AmorphousX/UMTK/README.md

# UMTK
Code for running UMTK

## Indicator LED

- Slow Flash: Not Connected
- Fast Flash: Running
- ON: Jogging
- OFF: Standby
