AmorphousX/UMTK/UMTK_ARDUINO/src/README.txt

This folder is the root of platformIO project
If need to be used with Arduino IDE, it must be symlinked somewhere, and be named UMTK
