AmorphousX/UMTK/PCB/V1/UMTK PCB/drawing.png

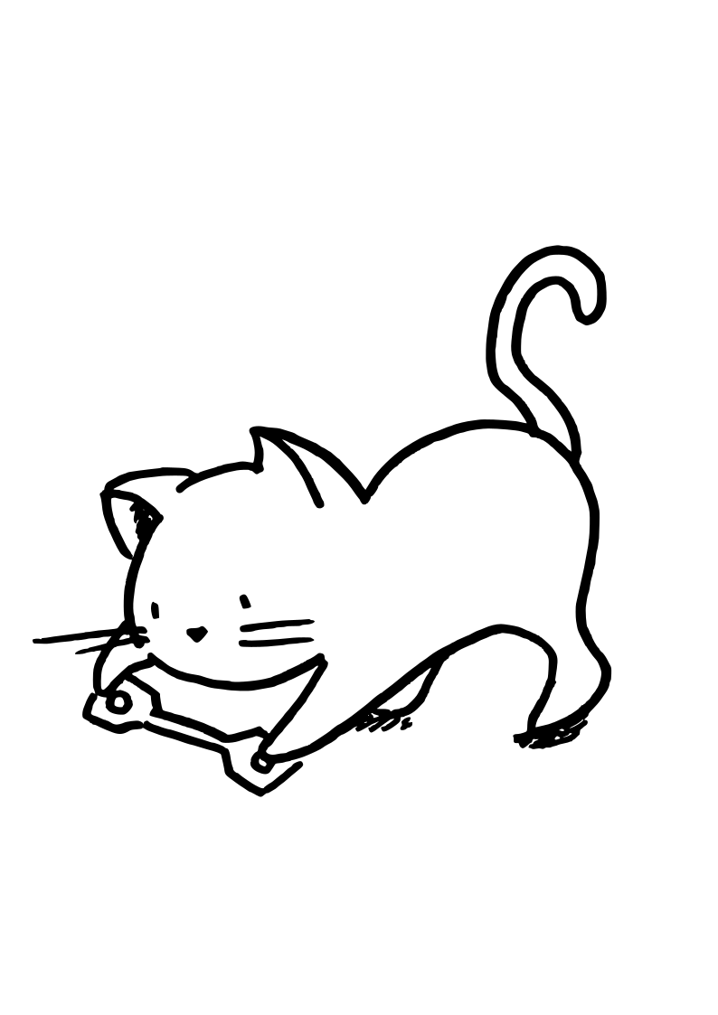
PCB/V1/UMTK PCB/drawing.png
