AmorphousX/UMTK/PCB/V1/UMTK PCB/PDF Image/UMTK_grey_Page_2.png

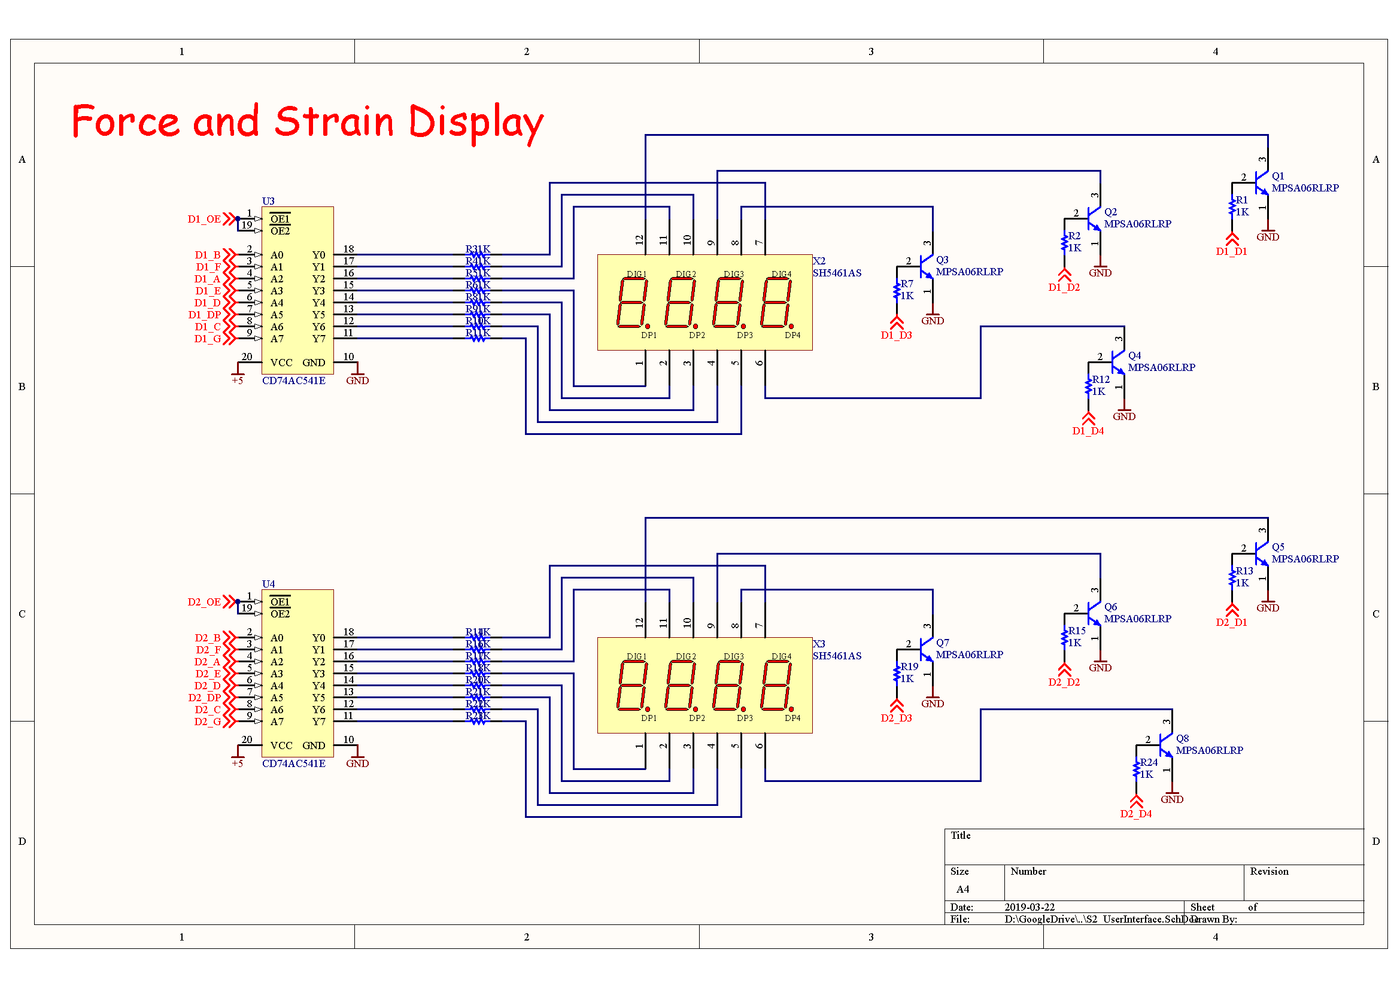
PCB/V1/UMTK PCB/PDF Image/UMTK_grey_Page_2.png
