AmorphousX/UMTK/PCB/V1/UMTK PCB/PDF Image/UMTK_grey_Page_5.png

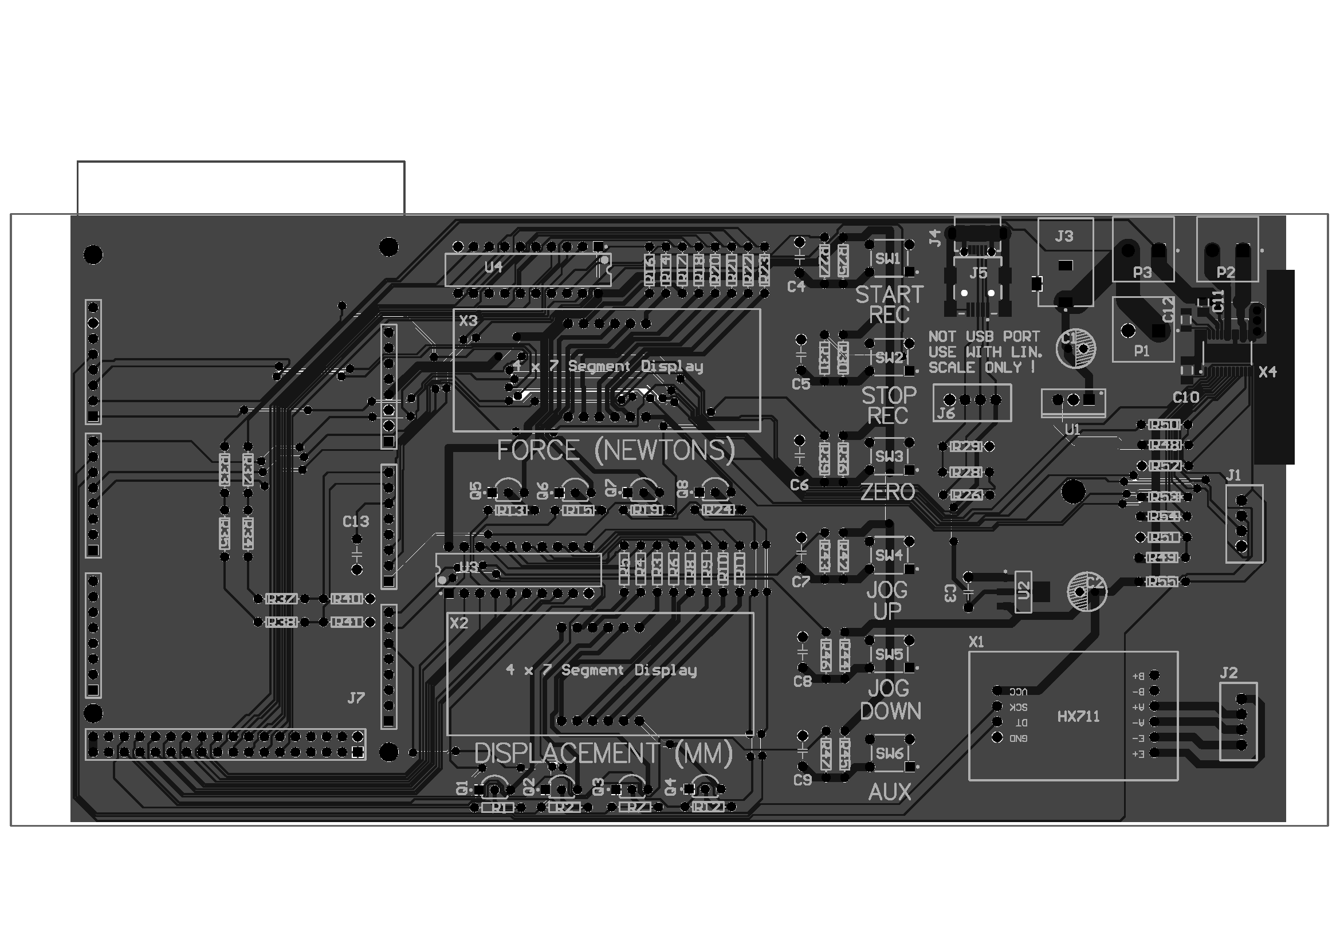
PCB/V1/UMTK PCB/PDF Image/UMTK_grey_Page_5.png
