AmorphousX/UMTK/UMTK_UI/v1.5/img/cat_1k.png

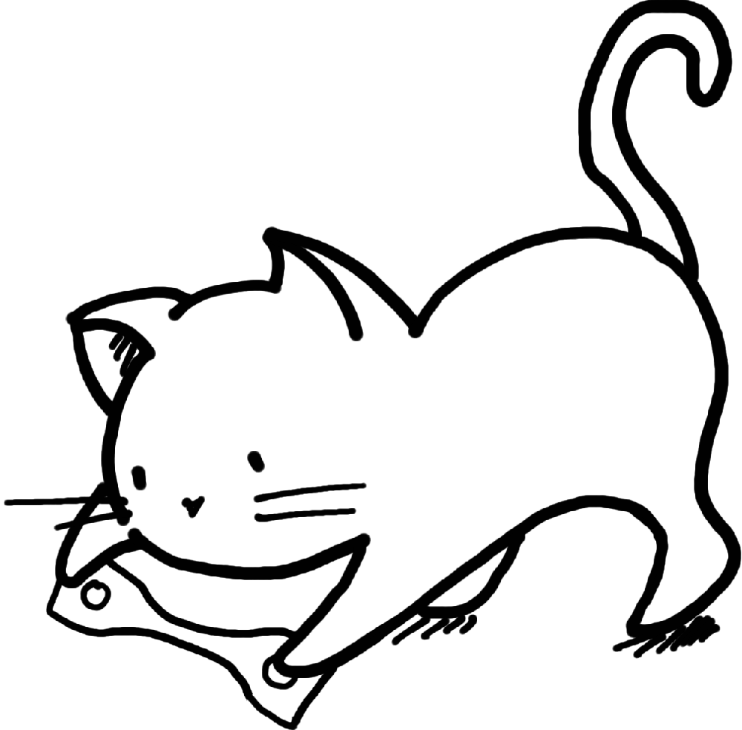
UMTK_UI/v1.5/img/cat_1k.png
