AmorphousX/UMTK/UMTK_UI/v1.5/img/cat_1k_dark.png

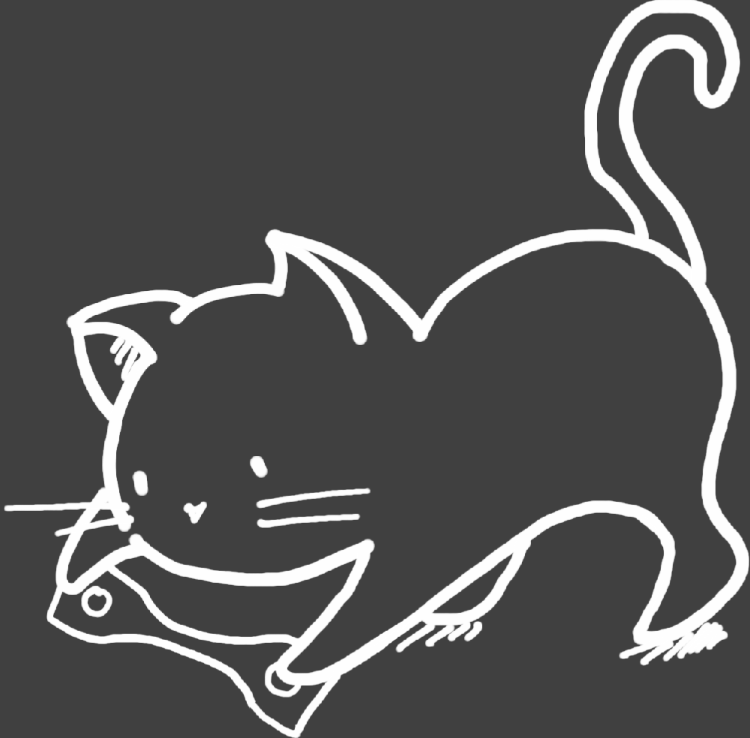
UMTK_UI/v1.5/img/cat_1k_dark.png
