AmorphousX/UMTK/PCB/V1/UMTK PCB/Project Outputs for UMTK/UMTK.xls

Comment | Description | Designator | Footprint | LibRef | Quantity | Need | Have
220u |  | C1, C2 | Alu Cap 6.3x2.5mm | Polar Cap | 2 | 8
0.1u |  | C3, C4, C5, C6, C7, C8, C9, C13 | Ceramic Cap 5mm | Cap | 8 | 32 | 32
CAP 1uF 6.3V 1206(3216) | CAP 1uF 6.3V ±20% 1206 (3216 Metric) Thickness 1.2mm SMD | C10 | CAPC1206(3216)130_M | CMP-1037-04669-1 | 1 | 4
CAP 1uF 25V 1206(3216) | CAP 1uF 25V ±10% 1206 (3216 Metric) Thickness 1.3mm SMD | C11 | CAPC1206(3216)130_M | CMP-1037-04700-1 | 1 | 4
CAP 47nF 50V 1206(3216) | CAP 47nF 50V ±20% 1206 (3216 Metric) Thickness 1.2mm SMD | C12 | CAPC1206(3216)130_L | CMP-1037-03986-1 | 1 | 4
JST 4pin |  | J1, J2, J6 | 4Pin JST | 4Pin JST | 3 | 12 | yes
PJ-102BH | Through Hole Right Angle DC Power Jack, 5 A, 2.5 mm Center Pin, 3 Position, -25 to 85 degC, RoHS, Bulk | J3 | CUI-PJ-102BH_V | CMP-2000-06901-1 | 1 | 4
47589-0001 | Right Angle Female Type AB Micro USB Connector, 30 V, 1.8 A, -30 to 85 degC, RoHS, Tape and Reel | J4 | MOLX-47589-0001_V | CMP-2000-05610-1 | 1 | 4
10033526-N3212LF | Mini USB B-Type, 5-Pin SMD, RoHS, Tape and Reel | J5 | FCI-10033526-N3212LF_V | CMP-1698-00001-2 | 1 | 4
NakedMega |  | J7 | ARDUINO MEGA | NakedMega | 1 | 4
SCREW-5.0/5.08 2WAYS | Socket, Screw Terminal Block, 2 Way, 5.0 mm Pitch, 90 Degree Angle, Through-Hole | P1, P2, P3 | SCREW-5.0-2WAYS_V | CMP-0617-00009-1 | 3 | 12
MPSA06RLRP | 80 V, 0.5 A, Amplifier Transistor, NPN Transistor, 3-Pin TO-92, Ammo Box | Q1, Q2, Q3, Q4, Q5, Q6, Q7, Q8 | ONSC-TO-92-3-29-11_AM_BL | CMP-1048-01505-1 | 8 | 32 | yes
Res1 | Resistor | R1, R2, R3, R4, R5, R6, R7, R8, R9, R10, R11, R12, R13, R14, R15, R16, R17, R18, R19, R20, R21, R22, R23, R24, R25, R26, R27, R28, R29, R30, R31, R32, R33, R34, R35, R36, R37, R38, R39, R40, R41, R42, R43, R44, R45, R46, R47, R48, R49, R50, R51, R52, R53, R54, R55 | AXIAL-0.3-3D | Res1 | 55 | 220 | yes
Tac Switch |  | SW1, SW2, SW3, SW4, SW5, SW6 | TacSwitch | Tac Switch | 6 | 24 | 24
L7805_Side |  | U1 | TO220_Side Mount | L7805_Side | 1 | 4 | yes
LD1117AS33TR | 1A, Low Drop Positive Voltage Regulator, 3.3V, 4-Pin SOT-223, Tape and Reel | U2 | SOT-223_M | CMP-0244-00316-1 | 1 | 4 | yes
CD74AC541E | Non-Inverting Octal Buffer/Line Drivers with 3-State Outputs, N0020A, TUBE | U3, U4 | N0020A | CMP-0440-00981-2 | 2 | 8
HX711_Board |  | X1 | HX711_Board_Large | HX711_Board | 1 | 4 | 4
SH5461AS | 4 Character 7 Segment Display, Common Cathode | X2, X3 | 4x7Seg | 4x7Seg | 2 | 8 | 8
DRV8873H | DRV8873-Q1 Automotive H-Bridge Motor Driver This one is the H version, with Hbridge gate controls (no SPI) | X4 | DRV8873 | DRV8873 | 1 | 4
