AmorphousX/UMTK/PCB/UMTK_V1_5/UMTK.step

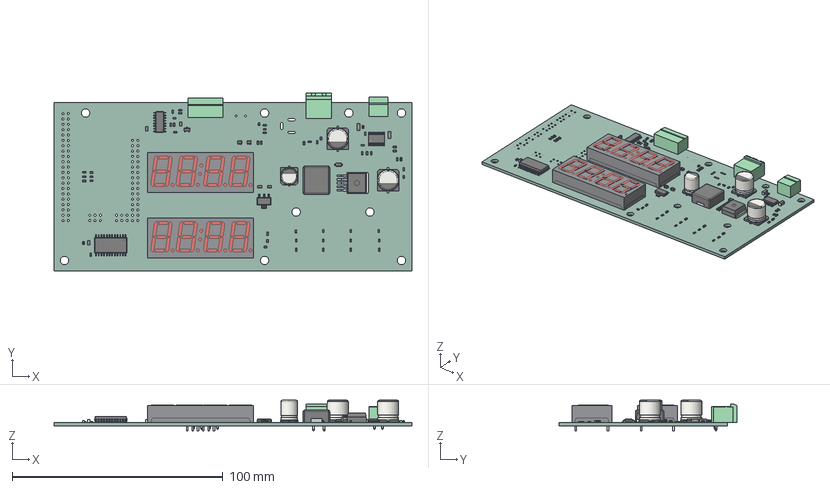
[picture p10: CAD file, 2024-09-10]
PCB/UMTK_V1_5/UMTK.step
170.0 x 84.5 x 14.5 mm
MC_01x02_G_3_81mm
C_0805_2012Metric x 5
C_0603_1608Metric x 14
R_0603_1608Metric x 36
D_SOD_523 x 2
SOIC_24W_75x154mm_P127mm
CQ assembly x 2
SOT_363_SC_70_6 x 2
C_1206_3216Metric x 2
CP_Elec_10x105 x 2
SOT_223
SOP-16_3.9x9.9mm_P1.27mm
Body_sp x 2
CP_Elec_8x105
D_SOD_123
HTSSOP_24_1EP_44x78mm_P065mm_EP34x78mm_Mask24x468mm
SOT_23
MC_01x04_G_3_81mm
MSTBA_01x02_G_5_08mm
UMTK_PCB
