AmorphousX/UMTK/PCB/v1.5_QA_Checklist.odt

PCB v1.5 QA Checklist

Date: 2024 Sep 15

- Power ON
- Display Segments
- Force +
- Force -
- Displacment +
- Displacement -
- LED Status light
- Motor Drive UP
- Motor Drive DOWN
- Tare
- Start Run
- Serial Print
- AUX Button Functions
- Remove Manufaturing Rail
- Temrinal – Loadcell
- Terminal – ESTOP
- Terminal – Motor

SN:

Tester:

PCB v1.5 QA Checklist

Date: 2024 Sep 15

- Power ON
- Display Segments
- Force +
- Force -
- Displacment +
- Displacement -
- LED Status light
- Motor Drive UP
- Motor Drive DOWN
- Tare
- Start Run
- Serial Print
- AUX Button Functions
- Remove Manufaturing Rail
- Temrinal – Loadcell
- Terminal – ESTOP
- Terminal – Motor

SN:

Tester:

PCB v1.5 QA Checklist

Date: 2024 Sep 15

- Power ON
- Display Segments
- Force +
- Force -
- Displacment +
- Displacement -
- LED Status light
- Motor Drive UP
- Motor Drive DOWN
- Tare
- Start Run
- Serial Print
- AUX Button Functions
- Remove Manufaturing Rail
- Temrinal – Loadcell
- Terminal – ESTOP
- Terminal – Motor

SN:

Tester:

PCB v1.5 QA Checklist

Date: 2024 Sep 15

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

SN:

Tester:
