AmorphousX/UMTK/(threads)

Thread 1 (2025-03-29):

UMTK PCB 1.6

MichaelDing313, 2025-03-29:
Need to fix issues discovered with PCB Version 1.5:

- EMI (maybe) from motor hitting endstop causes the slide to reset
  - Still need to investigate exactly why
  - Other functions don't seem affected
  - There is low capacitance on the power supply rails of slide, seems like easy mitigation

Thread 2 (2025-08-31):

McGill Meeting, Improvments

MichaelDing313, 2025-08-31:
Meeting with mcgill with feedbacks:

# GUI Issues:

- GUI Need to be started after USB plugin, rescan no work
- GUI Scaling
- GUI Install
  - Python version conflict on macos, With preinstalled python causes gui to fail
  -

# Hardware Issue:

- Calibration causes reading to be out of range
  - Calibration with bad values causes calibration values to be far out of range, and causes re-calibrations to fail
  -

Thread 3 (2025-08-31):

Mechanical Upgrade for slower strain rate

MichaelDing313, 2025-08-31:
We need much slower strain rate on the tests.

I think this is better done by getting a linear actuator with encoder, so we can optionally connect the encoder and drive the motors much slower than we otherwise able to.

- PCB needs to be updated with an optional encoder input. Absent encoder, we still need to rely on slide position.
- Software need to be updated to count the encoder. check if MEGA2560 can do it in hardware
- Find and buy motor with encoders.

MichaelDing313, 2025-08-31:
Ballpark say we target 20Khz - 100Khz max encoder frequency  at max speed.
Any higher we can also revert back to using linear slide as feedback and not encoder.

Spec for the linear actuator we used for v1.5 is:
- Load 6mm/s
- Unloaded 8mm/s
