AmorphousX/UMTK/(list of files, drawings)

Other design files:
PCB/V1/UMTK PCB/S1_Connections.SchDoc
PCB/V1/UMTK PCB/S2_UserInterface.SchDoc
PCB/V1/UMTK PCB/S3_Arduino.SchDoc
PCB/V1/UMTK PCB/S4_MotorDriver.SchDoc
PCB/V1/UMTK PCB/UMTK.PrjPCB
