AmorphousX/UMTK/PCB/UMTK_V1_5/UMTK.kicad_pcb

## KiCad design PCB/UMTK_V1_5/UMTK.kicad_pcb (2024-09-10)

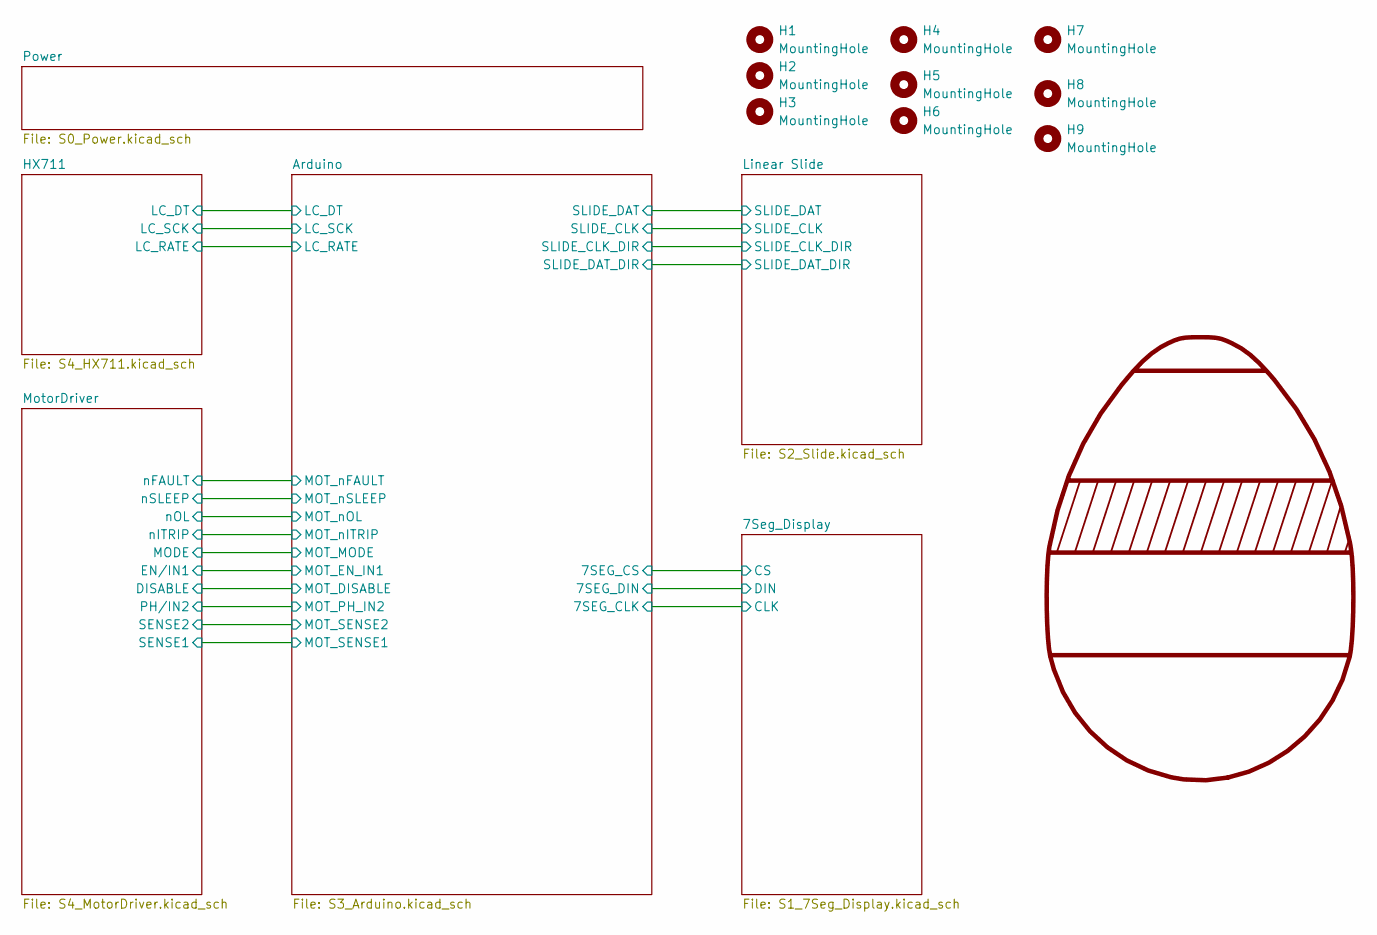
[picture p21: schematic UMTK.kicad_sch]

Parts:
G1: Tensile Cat
H1, H2, H3, H4, H5, H6, H7, H8, H9: MountingHole; MountingHole_4mm

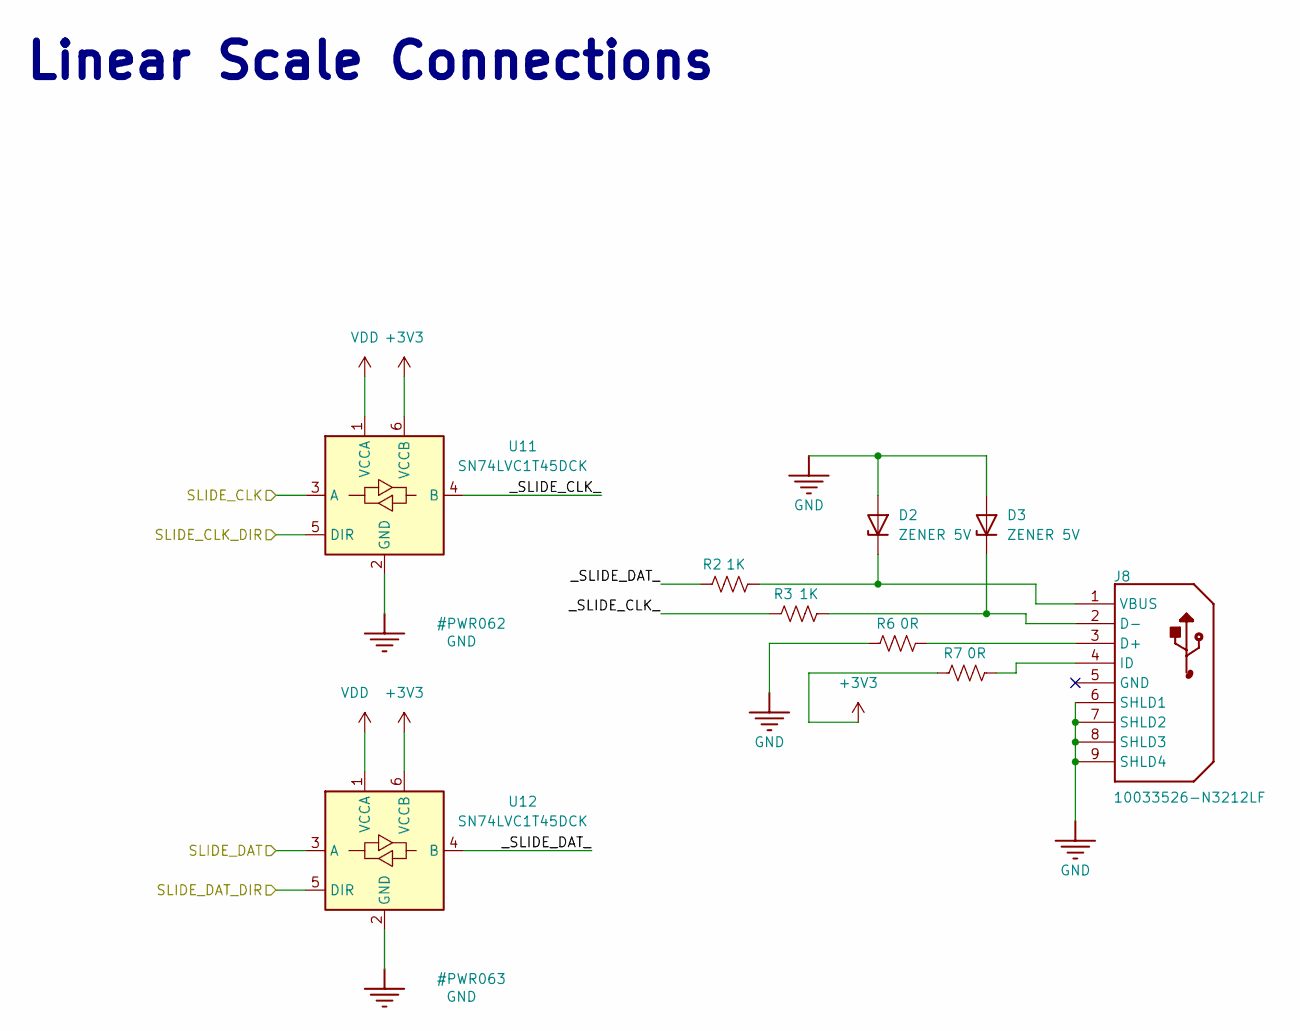
[picture p22: schematic S2_Slide.kicad_sch]

Parts:
D2, D3: ZENER 5V; D_SOD-523
J8: 10033526-N3212LF; USB_Mini-B_Wuerth_65100516121_Horizontal; FLAMMABILITY RATING UL 94 V-0; PARTNUMBER 10033526-N3212LF
R2, R3: 1K; R_0603_1608Metric
R6, R7: 0R; R_0603_1608Metric
U11, U12: SN74LVC1T45DCK; SOT-363_SC-70-6

Connections:
+3V3: R7.1, U11.6 (VCCB), U12.6 (VCCB); also elsewhere on the board
+5V: U11.1 (VCCA), U12.1 (VCCA); also elsewhere on the board
/Arduino/SLIDE_CLK: U11.3 (A); also elsewhere on the board
/Arduino/SLIDE_CLK_DIR: U11.5 (DIR); also elsewhere on the board
/Arduino/SLIDE_DAT: U12.3 (A); also elsewhere on the board
/Arduino/SLIDE_DAT_DIR: U12.5 (DIR); also elsewhere on the board
/Linear Slide/_SLIDE_CLK_: R3.1, U11.4 (B)
/Linear Slide/_SLIDE_DAT_: R2.1, U12.4 (B)
GND: D2.2 (A), D3.2 (A), J8.6 (SHLD1), J8.7 (SHLD2), J8.8 (SHLD3), J8.9 (SHLD4), R6.1, U11.2 (GND), U12.2 (GND); also elsewhere on the board
unnamed: D2.1 (K), J8.1 (VBUS), R2.2
unnamed: D3.1 (K), J8.2 (D-), R3.2
unnamed: J8.3 (D+), R6.2
unnamed: J8.4 (ID), R7.2

Notes on the sheet:
Linear Scale Connections

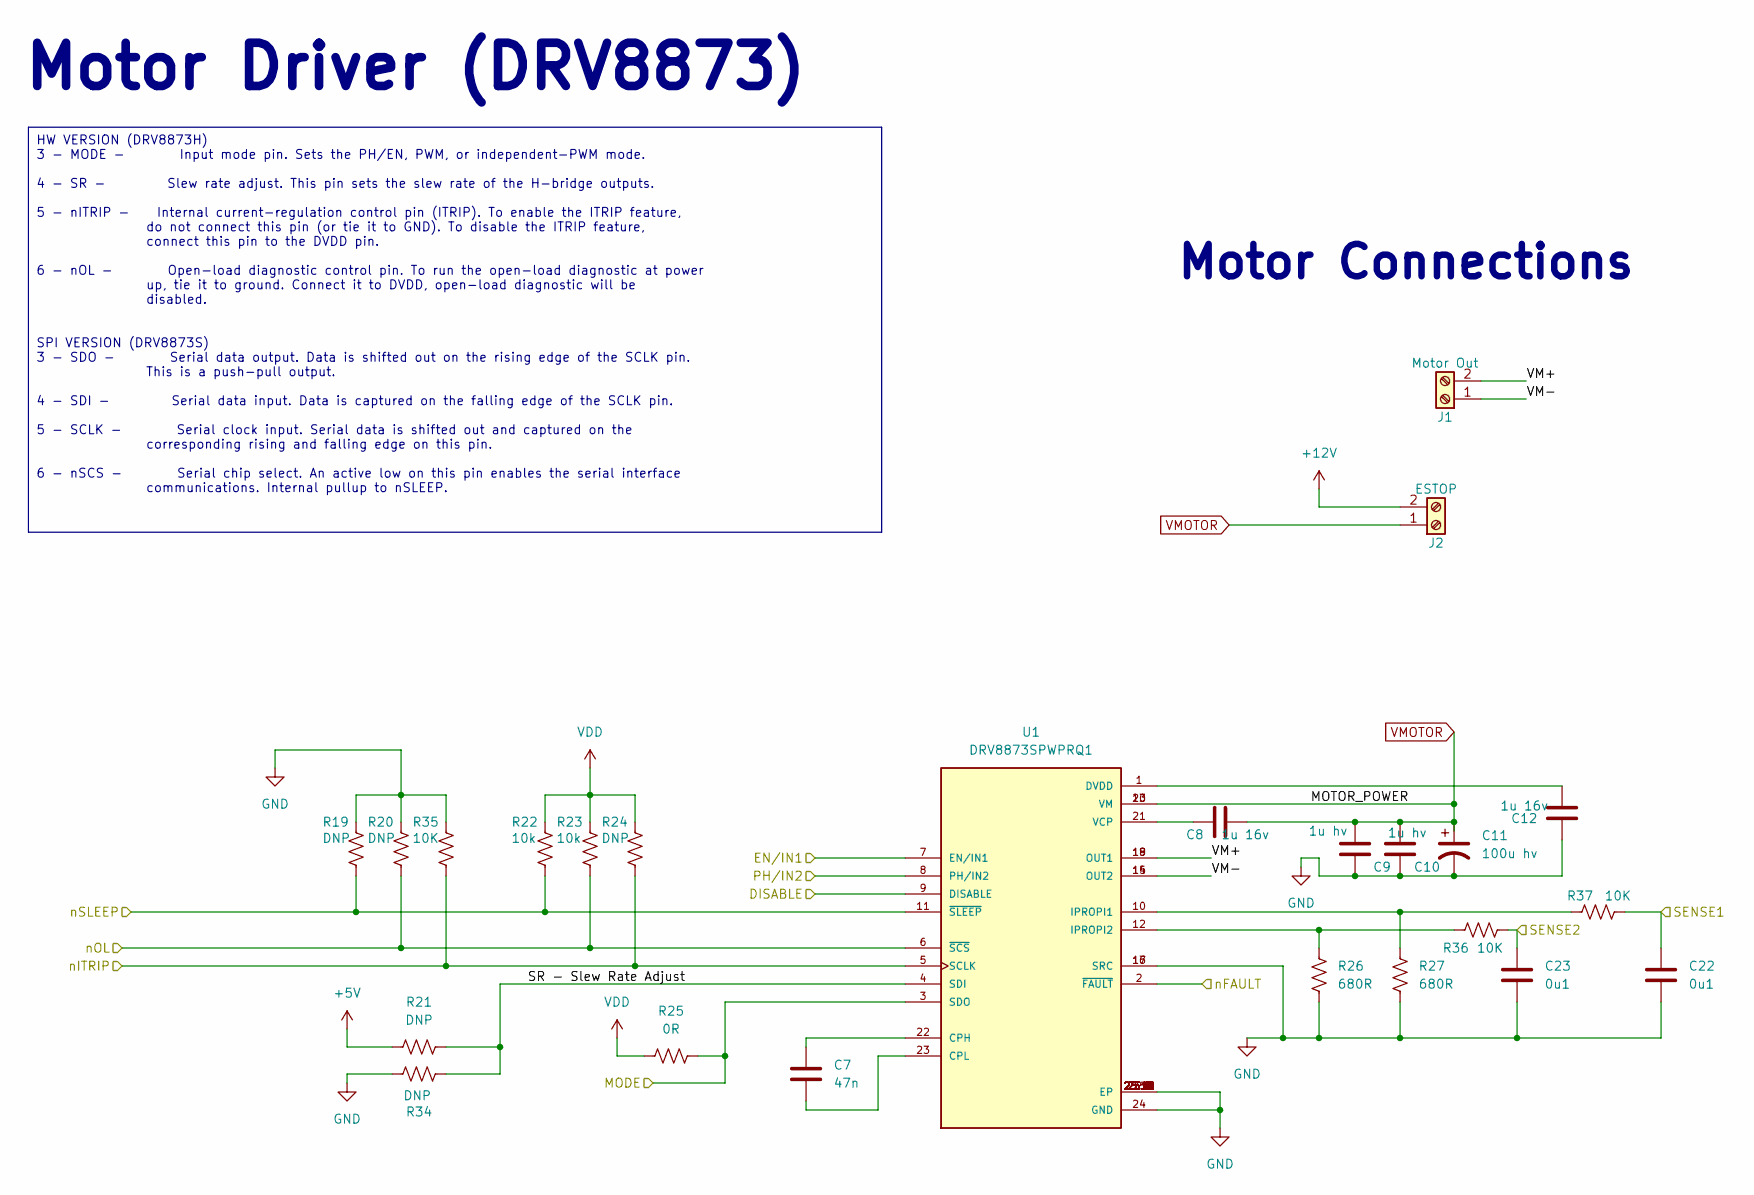
[picture p23: schematic S4_MotorDriver.kicad_sch]

Parts:
C7: 47n; C_0603_1608Metric
C8, C12: 1u 16v; C_0603_1608Metric
C9, C10: 1u hv; C_1206_3216Metric
C11: 100u hv; CP_Elec_10x10.5
C22, C23: 0u1; C_0603_1608Metric
J1: Motor Out; PhoenixContact_MC_1,5_2-G-3.81_1x02_P3.81mm_Horizontal
J2: ESTOP; PhoenixContact_MSTBA_2,5_2-G-5,08_1x02_P5.08mm_Horizontal
R19, R20, R21, R24, R34: DNP; R_0603_1608Metric
R22, R23: 10k; R_0603_1608Metric
R25: 0R; R_0603_1608Metric
R26, R27: 680R; R_0603_1608Metric
R35, R36, R37: 10K; R_0603_1608Metric
U1: DRV8873SPWPRQ1; HTSSOP-24-1EP_4.4x7.8mm_P0.65mm_EP3.4x7.8mm_Mask2.4x4.68mm_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; PARTREV A

Connections:
+5V: R21.2, R22.2, R23.2, R24.2, R25.1; also elsewhere on the board
+12V: J2.2; also elsewhere on the board
/Arduino/MOT_DISABLE: U1.9 (DISABLE); also elsewhere on the board
/Arduino/MOT_EN_IN1: U1.7 (EN/IN1); also elsewhere on the board
/Arduino/MOT_MODE: R25.2, U1.3 (SDO); also elsewhere on the board
/Arduino/MOT_PH_IN2: U1.8 (PH/IN2); also elsewhere on the board
/Arduino/MOT_SENSE1: C22.1, R37.2; also elsewhere on the board
/Arduino/MOT_SENSE2: C23.1, R36.2; also elsewhere on the board
/Arduino/MOT_nFAULT: U1.2 (~FAULT); also elsewhere on the board
/Arduino/MOT_nITRIP: R24.1, R35.1, U1.5 (SCLK); also elsewhere on the board
/Arduino/MOT_nOL: R20.1, R23.1, U1.6 (~SCS); also elsewhere on the board
/Arduino/MOT_nSLEEP: R19.1, R22.1, U1.11 (~SLEEP); also elsewhere on the board
/MotorDriver/SR - Slew Rate Adjust: R21.1, R34.2, U1.4 (SDI)
/MotorDriver/VM+: J1.2, U1.18 (OUT1), U1.19 (OUT1)
/MotorDriver/VM-: J1.1, U1.14 (OUT2), U1.15 (OUT2)
GND: C9.1, C10.1, C11.2, C12.2, C22.2, C23.2, R19.2, R20.2, R26.1, R27.1, R34.1, R35.2, U1.16 (SRC), U1.17 (SRC), U1.24 (GND), U1.25 (EP), U1.25.1 (EP), U1.25.2 (EP), U1.25.3 (EP), U1.25.4 (EP), U1.25.5 (EP), U1.25.6 (EP), U1.25.7 (EP), U1.25.8 (EP), U1.25.9 (EP), U1.25.10 (EP), U1.25.11 (EP), U1.25.12 (EP), U1.25.13 (EP), U1.25.14 (EP), U1.25.15 (EP), U1.25.16 (EP), U1.25.17 (EP), U1.25.18 (EP); also elsewhere on the board
unnamed: C7.1, U1.22 (CPH)
unnamed: C7.2, U1.23 (CPL)
unnamed: C12.1, U1.1 (DVDD)
unnamed: R27.2, R37.1, U1.10 (IPROPI1)
unnamed: R26.2, R36.1, U1.12 (IPROPI2)
unnamed: C8.1, U1.21 (VCP)
VMOTOR: C8.2, C9.2, C10.2, C11.1, J2.1, U1.13 (VM), U1.20 (VM); also elsewhere on the board

Notes on the sheet:
HW VERSION (DRV8873H) 3 - MODE - Input mode pin. Sets the PH/EN, PWM, or independent-PWM mode. 4 - SR - Slew rate adjust. This pin sets the slew rate of the H-bridge outputs. 5 - nITRIP - Internal current-regulation control pin (ITRIP). To enable the ITRIP feature, do not connect this pin (or tie i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
Motor Connections
Motor Driver (DRV8873)

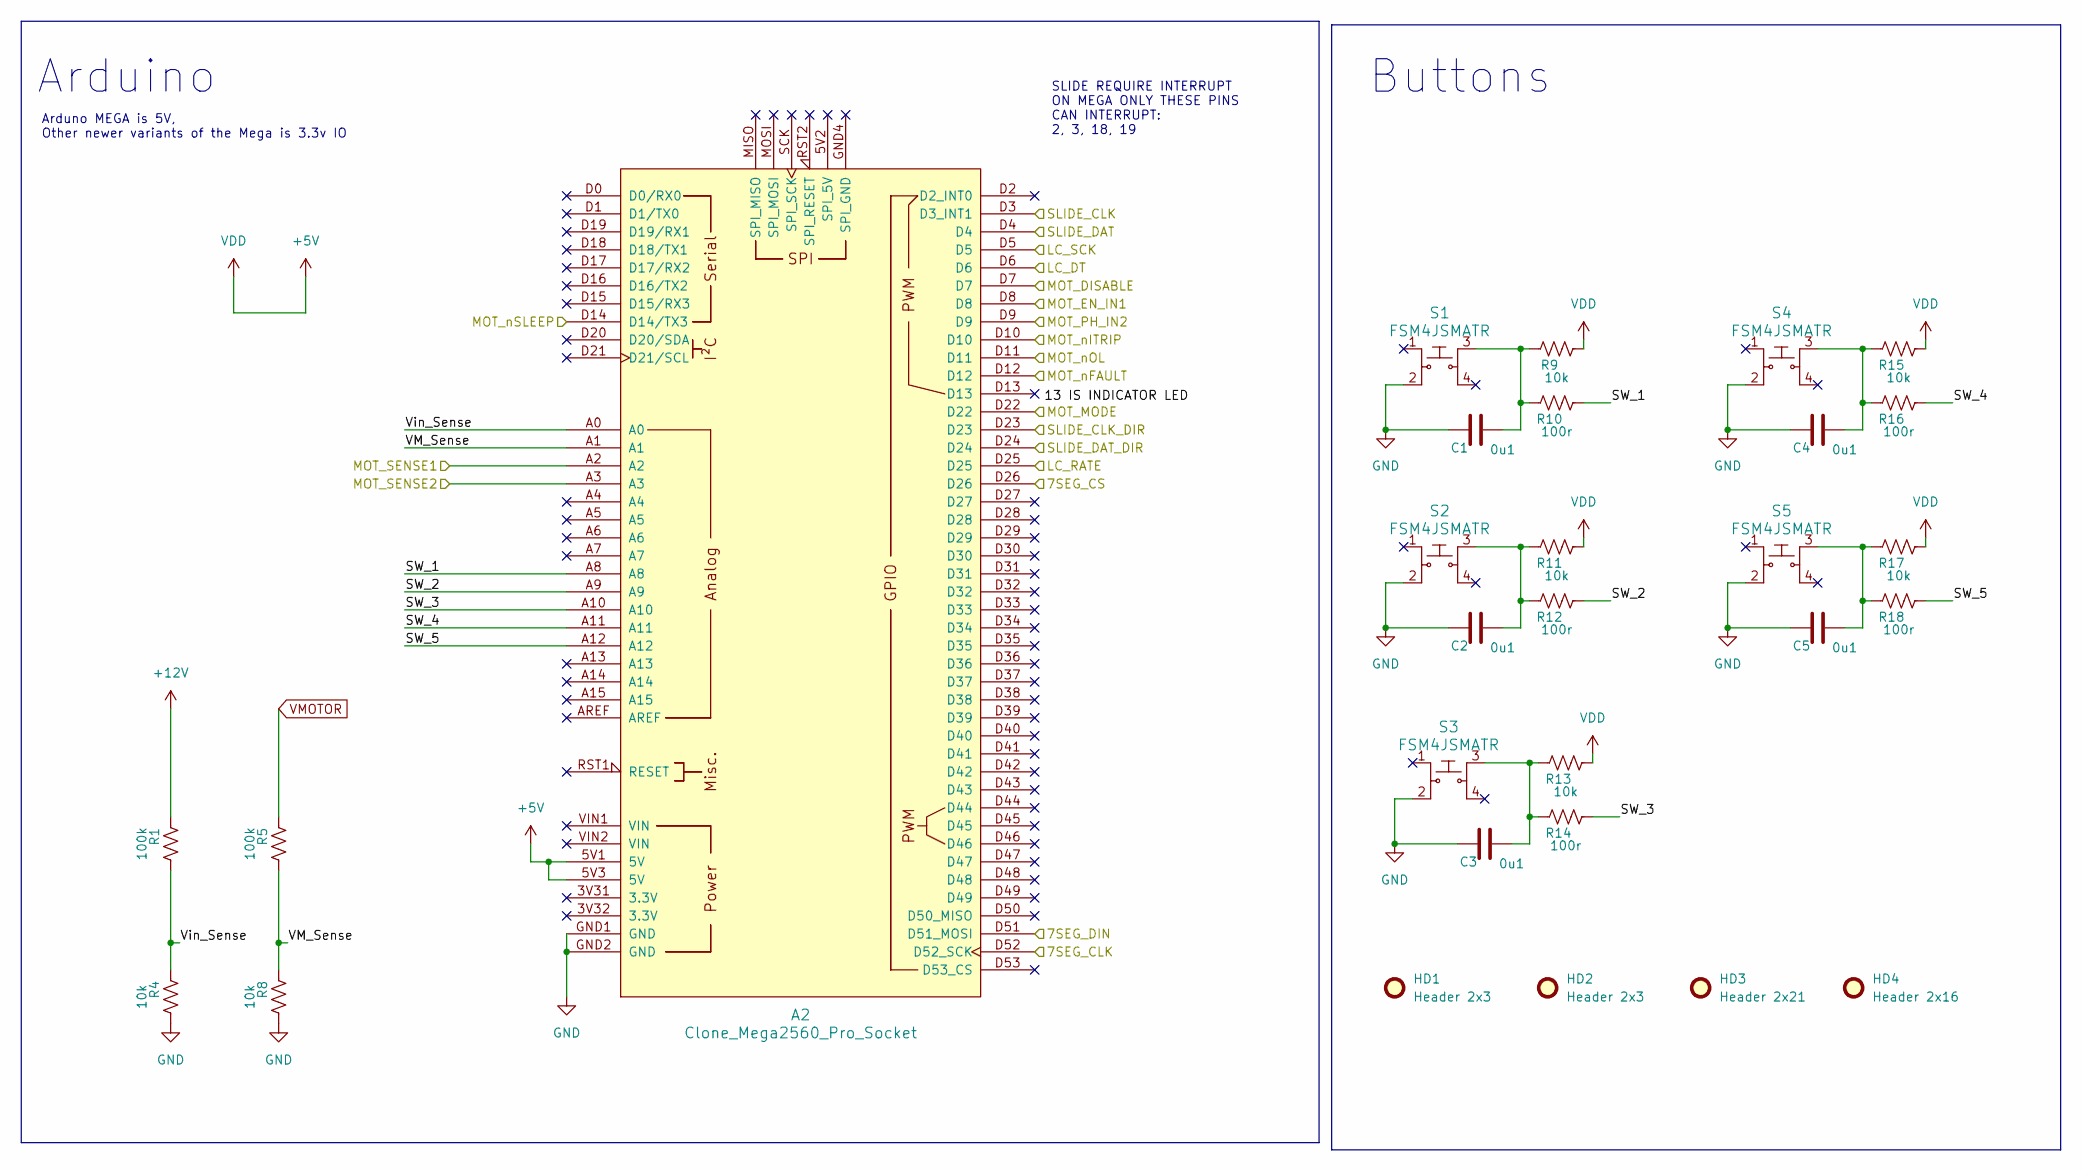
[picture p24: schematic S3_Arduino.kicad_sch]

Parts:
A2: Clone_Mega2560_Pro_Socket
C1, C2, C3, C4, C5: 0u1; C_0603_1608Metric
HD1, HD2: Header 2x3; Dummy_Header_2x3
HD3: Header 2x21; Dummy_Header_2x21
HD4: Header 2x16; Dummy_Header_2x16
R1, R5: 100k; R_0603_1608Metric
R4, R8, R9, R11, R13, R15, R17: 10k; R_0603_1608Metric
R10, R12, R14, R16, R18: 100r; R_0603_1608Metric
S1, S2, S3, S4, S5: FSM4JSMATR; Switch_Tactile_SMD_6x6mm; MPN FSM4JSMATR; Digi-Key_PN 450-1759-1-ND

Connections:
+5V: A2.5V1 (5V), A2.5V3 (5V), R9.2, R11.2, R13.2, R15.2, R17.2; also elsewhere on the board
+12V: R1.1; also elsewhere on the board
/7Seg_Display/CLK: A2.D52 (D52_SCK); also elsewhere on the board
/7Seg_Display/CS: A2.D26; also elsewhere on the board
/7Seg_Display/DIN: A2.D51 (D51_MOSI); also elsewhere on the board
/Arduino/LC_DT: A2.D6; also elsewhere on the board
/Arduino/LC_RATE: A2.D25; also elsewhere on the board
/Arduino/LC_SCK: A2.D5; also elsewhere on the board
/Arduino/MOT_DISABLE: A2.D7; also elsewhere on the board
/Arduino/MOT_EN_IN1: A2.D8; also elsewhere on the board
/Arduino/MOT_MODE: A2.D22; also elsewhere on the board
/Arduino/MOT_PH_IN2: A2.D9; also elsewhere on the board
/Arduino/MOT_SENSE1: A2.A2; also elsewhere on the board
/Arduino/MOT_SENSE2: A2.A3; also elsewhere on the board
/Arduino/MOT_nFAULT: A2.D12; also elsewhere on the board
/Arduino/MOT_nITRIP: A2.D10; also elsewhere on the board
/Arduino/MOT_nOL: A2.D11; also elsewhere on the board
/Arduino/MOT_nSLEEP: A2.D14 (D14/TX3); also elsewhere on the board
/Arduino/SLIDE_CLK: A2.D3 (D3_INT1); also elsewhere on the board
/Arduino/SLIDE_CLK_DIR: A2.D23; also elsewhere on the board
/Arduino/SLIDE_DAT: A2.D4; also elsewhere on the board
/Arduino/SLIDE_DAT_DIR: A2.D24; also elsewhere on the board
/Arduino/SW_1: A2.A8, R10.2
/Arduino/SW_2: A2.A9, R12.2
/Arduino/SW_3: A2.A10, R14.2
/Arduino/SW_4: A2.A11, R16.2
/Arduino/SW_5: A2.A12, R18.2
/Arduino/VM_Sense: A2.A1, R5.2, R8.1
/Arduino/Vin_Sense: A2.A0, R1.2, R4.1
GND: A2.GND1 (GND), A2.GND2 (GND), C1.1, C2.1, C3.1, C4.1, C5.1, R4.2, R8.2, S1.2, S2.2, S3.2, S4.2, S5.2; also elsewhere on the board
unnamed: C1.2, R9.1, R10.1, S1.3
unnamed: C2.2, R11.1, R12.1, S2.3
unnamed: C3.2, R13.1, R14.1, S3.3
unnamed: C4.2, R15.1, R16.1, S4.3
unnamed: C5.2, R17.1, R18.1, S5.3
VMOTOR: R5.1; also elsewhere on the board

Notes on the sheet:
Arduno MEGA is 5V, Other newer variants of the Mega is 3.3v IO
Arduino
SLIDE REQUIRE INTERRUPT ON MEGA ONLY THESE PINS CAN INTERRUPT: 2, 3, 18, 19
Buttons

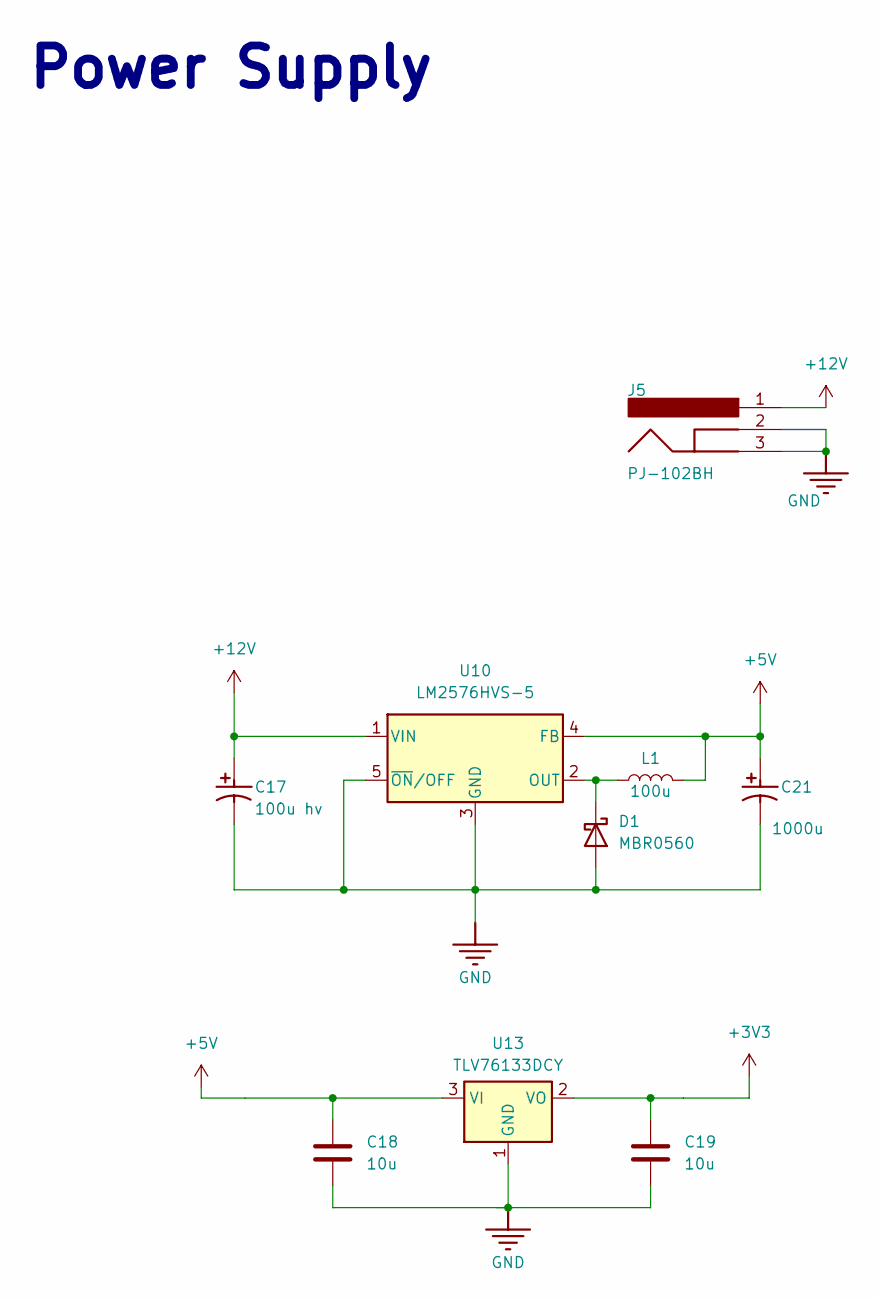
[picture p25: schematic S0_Power.kicad_sch]

Parts:
C17: 100u hv; CP_Elec_10x10.5
C18, C19: 10u; C_0805_2012Metric
C21: 1000u; CP_Elec_8x10.5
D1: MBR0560; D_SOD-123
J5: PJ-102BH; Barrel_Jack_5.5mmODx2.1mmID_PJ-202A; CURRENT RATING 5A; FLAMMABILITY RATING UL94V-0
L1: 100u; L_Sunlord_MWSA1206S-101
U10: LM2576HVS-5; TO-263-5_TabPin3
U13: TLV76133DCY; SOT-223-3_TabPin2

Connections:
+3V3: C19.2, U13.2 (VO); also elsewhere on the board
+5V: C18.2, C21.1, L1.2, U10.4 (FB), U13.3 (VI); also elsewhere on the board
+12V: C17.1, J5.1, U10.1 (VIN); also elsewhere on the board
GND: C17.2, C18.1, C19.1, C21.2, D1.2 (A), J5.2, J5.3, U10.3 (GND), U10.5 (~ON/OFF), U13.1 (GND); also elsewhere on the board
unnamed: D1.1 (K), L1.1, U10.2 (OUT)

Notes on the sheet:
Power Supply

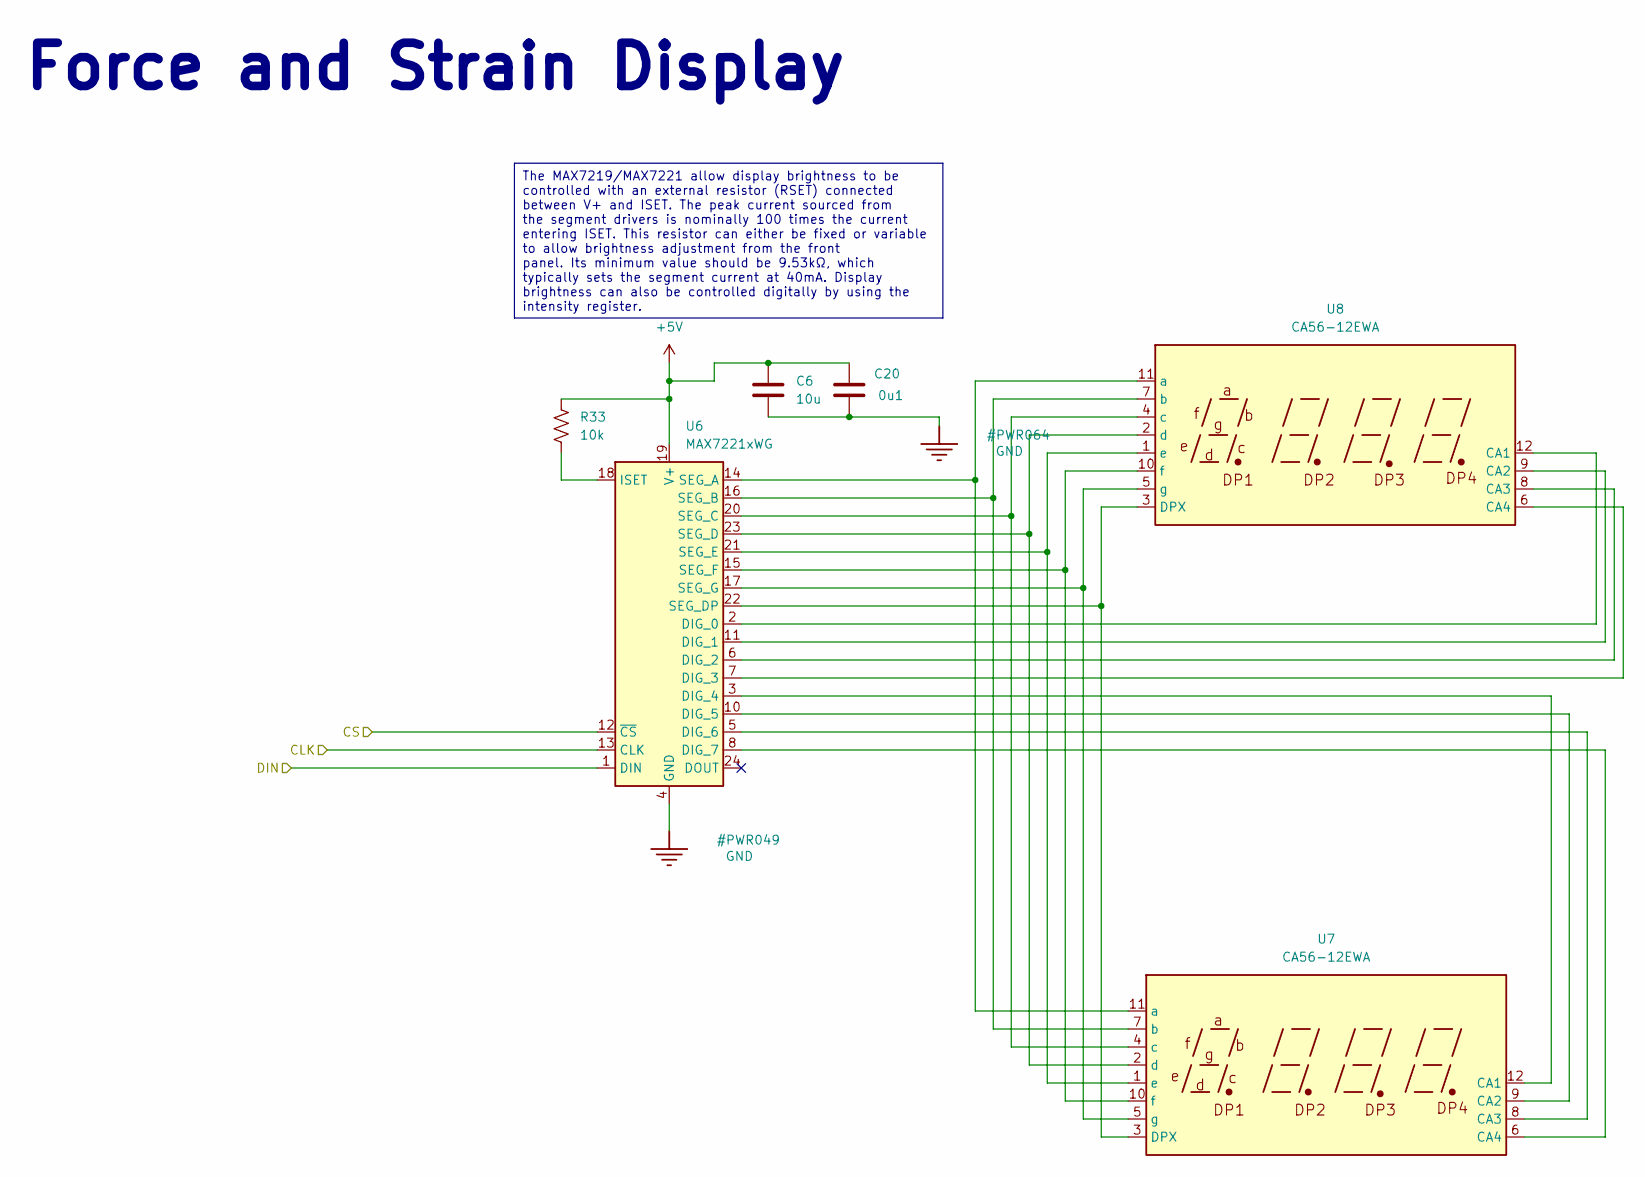
[picture p26: schematic S1_7Seg_Display.kicad_sch]

Parts:
C6: 10u; C_0805_2012Metric
C20: 0u1; C_0603_1608Metric
R33: 10k; R_0603_1608Metric
U6: MAX7221xWG; SOIC-24W_7.5x15.4mm_P1.27mm
U7, U8: CA56-12EWA

Connections:
+5V: C6.2, C20.2, R33.1, U6.19 (V+); also elsewhere on the board
/7Seg_Display/CLK: U6.13 (CLK); also elsewhere on the board
/7Seg_Display/CS: U6.12 (~CS); also elsewhere on the board
/7Seg_Display/DIN: U6.1 (DIN); also elsewhere on the board
GND: C6.1, C20.1, U6.4 (GND), U6.9 (GND); also elsewhere on the board
unnamed: U6.2 (DIG_0), U8.12 (CA1)
unnamed: U6.11 (DIG_1), U8.9 (CA2)
unnamed: U6.6 (DIG_2), U8.8 (CA3)
unnamed: U6.7 (DIG_3), U8.6 (CA4)
unnamed: U6.3 (DIG_4), U7.12 (CA1)
unnamed: U6.10 (DIG_5), U7.9 (CA2)
unnamed: U6.5 (DIG_6), U7.8 (CA3)
unnamed: U6.8 (DIG_7), U7.6 (CA4)
unnamed: R33.2, U6.18 (ISET)
unnamed: U6.14 (SEG_A), U7.11 (a), U8.11 (a)
unnamed: U6.16 (SEG_B), U7.7 (b), U8.7 (b)
unnamed: U6.20 (SEG_C), U7.4 (c), U8.4 (c)
unnamed: U6.23 (SEG_D), U7.2 (d), U8.2 (d)
unnamed: U6.22 (SEG_DP), U7.3 (DPX), U8.3 (DPX)
unnamed: U6.21 (SEG_E), U7.1 (e), U8.1 (e)
unnamed: U6.15 (SEG_F), U7.10 (f), U8.10 (f)
unnamed: U6.17 (SEG_G), U7.5 (g), U8.5 (g)

Notes on the sheet:
The MAX7219/MAX7221 allow display brightness to be controlled with an external resistor (RSET) connected between V+ and ISET. The peak current sourced from the segment drivers is nominally 100 times the current entering ISET. This resistor can either be fixed or variable to allow brightness adjustm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
Force and Strain Display

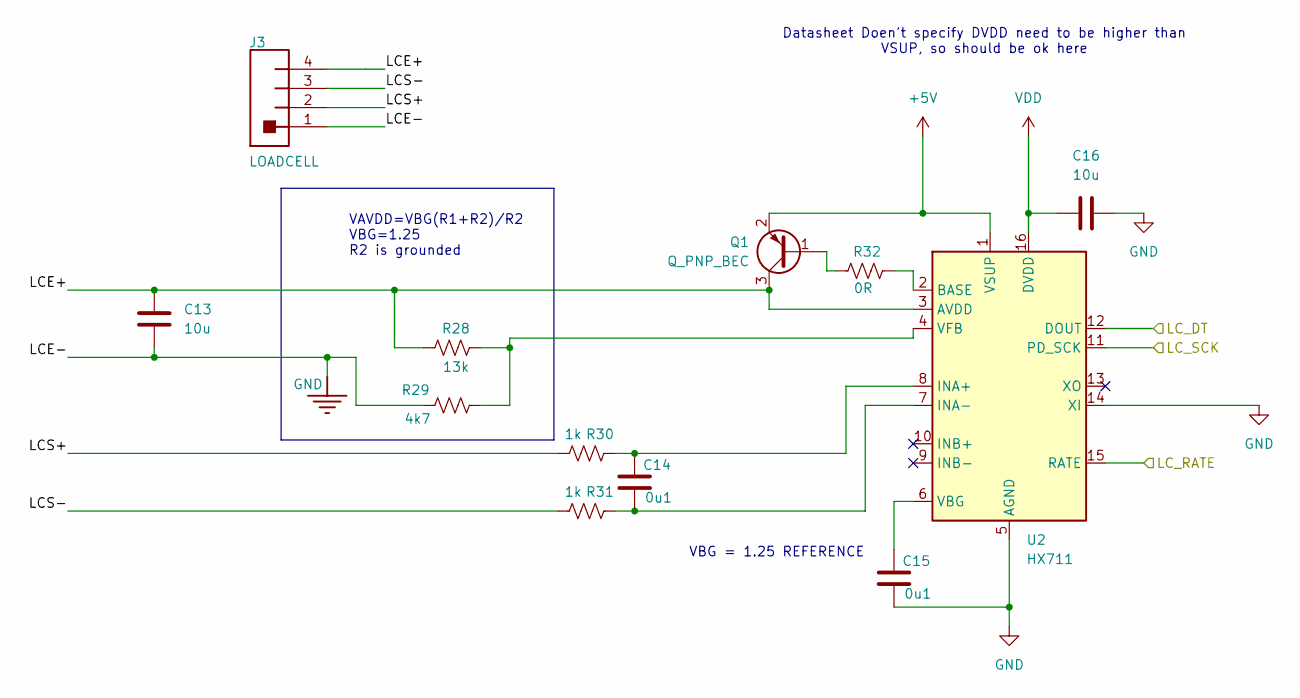
[picture p27: schematic S4_HX711.kicad_sch]

Parts:
C13, C16: 10u; C_0805_2012Metric
C14, C15: 0u1; C_0603_1608Metric
J3: LOADCELL; PhoenixContact_MC_1,5_4-G-3.81_1x04_P3.81mm_Horizontal
Q1: Q_PNP_BEC; SOT-23
R28: 13k; C_0603_1608Metric
R29: 4k7; R_0603_1608Metric
R30, R31: 1k; R_0603_1608Metric
R32: 0R; R_0603_1608Metric
U2: HX711; SOP-16_3.9x9.9mm_P1.27mm

Connections:
+5V: C16.1, Q1.2 (E), U2.1 (VSUP), U2.16 (DVDD); also elsewhere on the board
/Arduino/LC_DT: U2.12 (DOUT); also elsewhere on the board
/Arduino/LC_RATE: U2.15 (RATE); also elsewhere on the board
/Arduino/LC_SCK: U2.11 (PD_SCK); also elsewhere on the board
/HX711/LCE+: C13.2, J3.4, Q1.3 (C), R28.1, U2.3 (AVDD)
/HX711/LCS+: J3.2, R30.1
/HX711/LCS-: J3.3, R31.1
GND: C13.1, C15.2, C16.2, J3.1, R29.1, U2.5 (AGND), U2.14 (XI); also elsewhere on the board
unnamed: Q1.1 (B), R32.1
unnamed: R32.2, U2.2 (BASE)
unnamed: C14.1, R30.2, U2.8 (INA+)
unnamed: C14.2, R31.2, U2.7 (INA-)
unnamed: C15.1, U2.6 (VBG)
unnamed: R28.2, R29.2, U2.4 (VFB)

Notes on the sheet:
VBG = 1.25 REFERENCE
VAVDD=VBG(R1+R2)/R2 VBG=1.25 R2 is grounded
Datasheet Doen't specify DVDD need to be higher than VSUP, so should be ok here

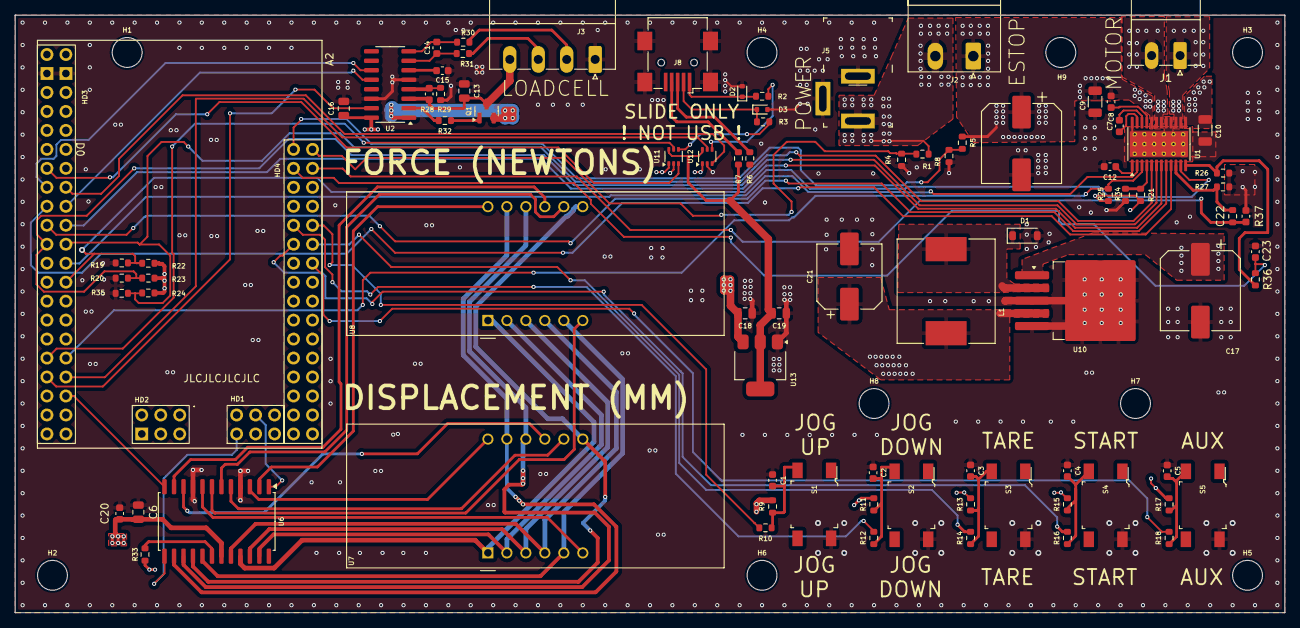
[picture p28: board UMTK.kicad_pcb from above]

Board: 4 copper layers, 170.0 x 80.0 mm, 99 parts (1 on the bottom side), 79 nets.
