AmorphousX/UMTK/(commit log)

2022-09-18 Initial Commit, Arduino Code
    Copy in arduino code from long ago
2022-09-18 previous umtk arduino code
2022-09-19 Convert to platformio, and working
    Converted project to use platformIO, better than arduino IDE.
    Also updated arduino code now it works with MMTK UI for display, tear, start, and stop
2024-06-25 Initial of UMTK_V1
    [S1_Connections.SchDoc, S2_UserInterface.SchDoc, S3_Arduino.SchDoc, S4_MotorDriver.SchDoc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]
2024-06-25 Import Schematic from altium
    [S1_Connections.kicad_sch, S2_UserInterface.kicad_sch, S3_Arduino.kicad_sch, S4_MotorDriver.kicad_sch, UMTK.kicad_pcb, UMTK.kicad_sch]
2024-06-27 Put in Files for V1
    [S1_7Seg_Display.kicad_sch, S1_Connections.kicad_sch, S2_UserInterface.kicad_sch, S3_Arduino.kicad_sch, S4_HX711.kicad_sch, S4_MotorDriver.kicad_sch, UMTK.kicad_pcb, UMTK.kicad_sch]
2024-06-27 Updated Schematics
    Done: 7 Seg, Power, Motor, Slide, HX711
    To Do: Arduino
    [S0_Power.kicad_sch, S1_7Seg_Display.kicad_sch, S1_Connections.kicad_sch, S2_Slide.kicad_sch, S3_Arduino.kicad_sch, S4_HX711.kicad_sch, S4_MotorDriver.kicad_sch, UMTK.kicad_sch]
2024-06-27 Export Subsheet Pin From 7Seg
    [S0_Power.kicad_sch, S1_7Seg_Display.kicad_sch, S2_Slide.kicad_sch, UMTK.kicad_sch]
2024-06-28 Updating Schematic
    [S2_Slide.kicad_sch, S3_Arduino.kicad_sch, S4_MotorDriver.kicad_sch, UMTK.kicad_sch]
2024-06-30 Schematic Done, Assigning footprint
    [S0_Power.kicad_sch, S1_7Seg_Display.kicad_sch, S2_Slide.kicad_sch, S3_Arduino.kicad_sch, S4_HX711.kicad_sch, S4_MotorDriver.kicad_sch, UMTK.kicad_sch]
2024-06-30 Footprint assign
    [S0_Power.kicad_sch, S1_7Seg_Display.kicad_sch, S2_Slide.kicad_sch, S3_Arduino.kicad_sch, S4_HX711.kicad_sch, S4_MotorDriver.kicad_sch]
2024-06-30 ERC good, imported into PCB
    [S0_Power.kicad_sch, S1_7Seg_Display.kicad_sch, S2_Slide.kicad_sch, S3_Arduino.kicad_sch, S4_HX711.kicad_sch, S4_MotorDriver.kicad_sch, UMTK.kicad_pcb]
2024-06-30 Updated DRC and pcb
    [UMTK.kicad_pcb]
2024-06-30 Initial Place, Board Stack
    [S0_Power.kicad_sch, S2_Slide.kicad_sch, S3_Arduino.kicad_sch, S4_HX711.kicad_sch, S4_MotorDriver.kicad_sch, UMTK.kicad_pcb]
2024-06-30 Layout Started
    [S2_Slide.kicad_sch, UMTK.kicad_pcb]
2024-07-01 Layout Continue
    [S0_Power.kicad_sch, UMTK.kicad_pcb]
2024-07-02 Placement Approved, Added holes
    [S3_Arduino.kicad_sch, S4_MotorDriver.kicad_sch, UMTK.kicad_pcb, UMTK.kicad_sch]
2024-07-03 WIP laying board
    [UMTK.kicad_pcb]
2024-07-03 Update Via sizes to 0.3 / 0.45
    [UMTK.kicad_pcb]
2024-07-06 Dumbass has push and shove routing off
    [UMTK.kicad_pcb]
2024-07-06 Routing Done
    [UMTK.kicad_pcb]
2024-07-06 Added Sinkscreen Annotations, PCB Done for now
    [S4_MotorDriver.kicad_sch, UMTK.kicad_pcb]
2024-07-06 Generating outputs
    [UMTK-B_Cu.gbl, UMTK-B_Mask.gbs, UMTK-B_Paste.gbp, UMTK-B_Silkscreen.gbo, UMTK-Edge_Cuts.gm1, UMTK-F_Cu.gtl, UMTK-F_Mask.gts, UMTK-F_Paste.gtp]
2024-07-07 Assigning JLC
    [BOM-UMTK.csv, S4_MotorDriver.kicad_sch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]
2024-07-08 Routing and JLC Assignment Done
    [S0_Power.kicad_sch, S3_Arduino.kicad_sch, S4_HX711.kicad_sch, S4_MotorDriver.kicad_sch, UMTK.kicad_pcb]
2024-07-08 PCB improvment
    [UMTK.kicad_pcb]
2024-07-09 Seem to be all done
    [UMTK.kicad_pcb]
2024-07-09 Grounding Improvments
    [UMTK.kicad_pcb]
2024-07-09 improve vias location
    [UMTK.kicad_pcb]
2024-07-11 Generate step file, board looks good submitting
    [UMTK.step]
2024-07-11 Uodated Production File, added JLC part number
    [BOM-UMTK.csv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]
2024-07-12 Update PCB and production files, production files sent
    [BOM-UMTK.csv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]
2024-07-27 Bug fixes and add dummy headers for DFM
    Fix:
    - Power jack footprint incorrect for high current jack
    - Motor and Estop terminal hole size too small
    - Added designator and position for arduino headers for DFM
    [S0_Power.kicad_sch, S3_Arduino.kicad_sch, S4_MotorDriver.kicad_sch, UMTK.kicad_pcb, UMTK.kicad_sch]
2024-07-27 Added pin assignment doc for firmware
    [S3_Arduino.kicad_sch, UMTK.kicad_sch]
2024-07-28 Make simple components bigger
    [S1_7Seg_Display.kicad_sch, S3_Arduino.kicad_sch, S4_HX711.kicad_sch, S4_MotorDriver.kicad_sch, UMTK.kicad_pcb]
2024-07-29 Debugging firmware, feature add
    Added feature to disable leading zeros and turn them off.
    Updating PCB, all general parts should be 0603 by default.
    Add configratble decimal point location
    [UMTK.kicad_pcb]
2024-07-31 Updated slide pinout, add protection, Fixed some issues
    [S2_Slide.kicad_sch, UMTK.kicad_pcb]
2024-07-31 Add a bit of decoupling for 7seg driver
    [S1_7Seg_Display.kicad_sch, UMTK.kicad_pcb]
2024-07-31 Add devoupling for 7seg
    [UMTK.kicad_pcb]
2024-08-01 Move interrupr pin to 3, Move motor sleep to 14 so 13 can LED
    [S3_Arduino.kicad_sch, UMTK.kicad_pcb]
2024-08-01 Update pin map, remove one from PCB files
2024-08-01 Cleanup and update PCB
    [UMTK.kicad_pcb]
2024-08-02 Update Firmware
    [S4_MotorDriver.kicad_sch]
2024-08-03 PCB Revision
    - Add filter for 7seg power again
    - Add low pass filter for output of motor power sense
    [S1_7Seg_Display.kicad_sch, S3_Arduino.kicad_sch, S4_MotorDriver.kicad_sch, UMTK.kicad_pcb]
2024-08-03 JLC Assigned for updated PCB, ready to send again
    [UMTK.kicad_pcb]
2024-08-04 Jog by serial done, should tweak the jog timer
2024-08-04 Added new gui to git, add voltages to firmware prints
2024-08-04 Add simple filtering to loadcell reading, slow PID loop
2024-08-04 UPdate PCB for better thermals for motor driver
    [UMTK.kicad_pcb]
2024-08-04 Update PCB, Generate JLC again
    [CPL-UMTK.csv, UMTK-CuBottom.gbr, UMTK-CuIn1.gbr, UMTK-CuIn2.gbr, UMTK-CuTop.gbr, UMTK-EdgeCuts.gbr, UMTK-MaskBottom.gbr, UMTK-MaskTop.gbr]
2024-08-04 Update PCB Back Silkscreen
    [UMTK.kicad_pcb]
2024-08-04 Update stuff, jlc seems broken for some reason
    [BOM-UMTK.csv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]
2024-08-05 Update prod File Remove old silkscreen notes from front
    [BOM-UMTK.csv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]
2024-08-06 Update UMTK_UI_1v5.py
    Re modified the UI.
    - Removed dial, and duplicate buttons
    - Added text field to set speed.
2024-08-09 Updated prod file to include plug side connectors
    [BOM-UMTK - Copy.csv, BOM-UMTK.csv, BOM-UMTK_MANUAL_ADD_PLUGS.csv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]
2024-08-17 Added Calibration menu
    new layout, calibration labels, inline text box and labels
2024-08-17 Update Arduino Code for V1.5 Run of PCB
2024-08-17 WIP Save buttons and plot working
2024-08-17 Motor bars work but I don't like how it looks rn
2024-08-18 Restore calibration from eeprom, Add a calibration rescue
2024-08-18 Make button inputs pullup so buttons read as high when not connected
2024-09-06 Update motor sense voltage reading
    [UMTK.step]
2024-09-08 UI Updates - change motor stall progress bar to button
    UI Updates - change motor stall progress bar to button
2024-09-09 Remove motor stall detection from firmware, add it in GUI only
    [main.cpp, main.h, main.py]
2024-09-12 update firmware, current sens pins flipped, update header text to be correct
    [main.cpp, main.h]
2024-09-15 Clean up arduino folders and move files
2024-09-15 Add stall detection and stop functionality
    [main.cpp, main.h]
2024-09-15 Add QA checklist, update firmware to reset caliration properly
    [main.cpp, main.h]
2024-09-16 Firmware fixes to correctly store data for calibration
    [main.cpp, main.h]
2024-09-16 remove pycache, add comatibility for gui logging millis
2024-09-16 Gui function update, fix motor stall button red, validate against new firmware
    [main.py]
2024-09-16 Fix emergency stop display
    [main.py]
2024-09-17 update gui, estop volts threashold is 8v now
